Eelis/ShoelaceAnchor/TODO.txt

open issues:
    - how to keep tie-wrap buckle fixed on one side or the other?
    - tongue of right shoe keeps drifting to the right. why?
    - now that anchor is so small, knot that binds lace ends is the biggest bulk. is there a good way to reduce this (without infringing on foot space)?
