Eelis/ShoelaceAnchor/(commit log)

2024-11-14 Add everything.
    [anchor.scad, scene.scad, util.scad]
2025-02-23 Enable wind+twist.
    [anchor.scad, scene.scad]
2025-02-23 Remove one pole.
    [anchor.scad]
2025-02-23 Change to Type II Paracord (3mm).
    [anchor.scad, scene.scad]
2025-02-24 Add center pillar.
    [anchor.scad, scene.scad]
2025-02-24 Tweak non-tall sidewall height.
    [anchor.scad]
2025-02-24 Replace center pillar with blinder.
    [anchor.scad]
2025-02-24 Tweak constants.
    [anchor.scad]
2025-02-24 Align roof and floor with locks.
    [anchor.scad]
2025-02-24 Replace poles with wedges.
    [anchor.scad, scene.scad]
2025-02-26 Make floor and ceiling smaller.
    [anchor.scad]
2025-02-26 Make wedges smaller.
    [anchor.scad]
2025-02-26 Increase pipe_diam to 2.5.
    [anchor.scad]
2025-02-26 Make anchor wider and replace blinder with center pole.
    [anchor.scad, scene.scad]
2025-02-26 Make lock a bit smaller.
    [anchor.scad, scene.scad]
2025-03-26 Remove center pole.
    [anchor.scad]
2025-03-26 Smoothen wedges.
    [anchor.scad]
2025-05-07 Increase total width by 1.5mm.
    [anchor.scad]
2025-05-07 Restore center pole, but offset to the side.
    [anchor.scad]
2025-05-07 Reduce pipe_diam to 2.4.
    [anchor.scad]
